microfarad-de/fridge-controller/doc/fridge-controller-schematic.pdf

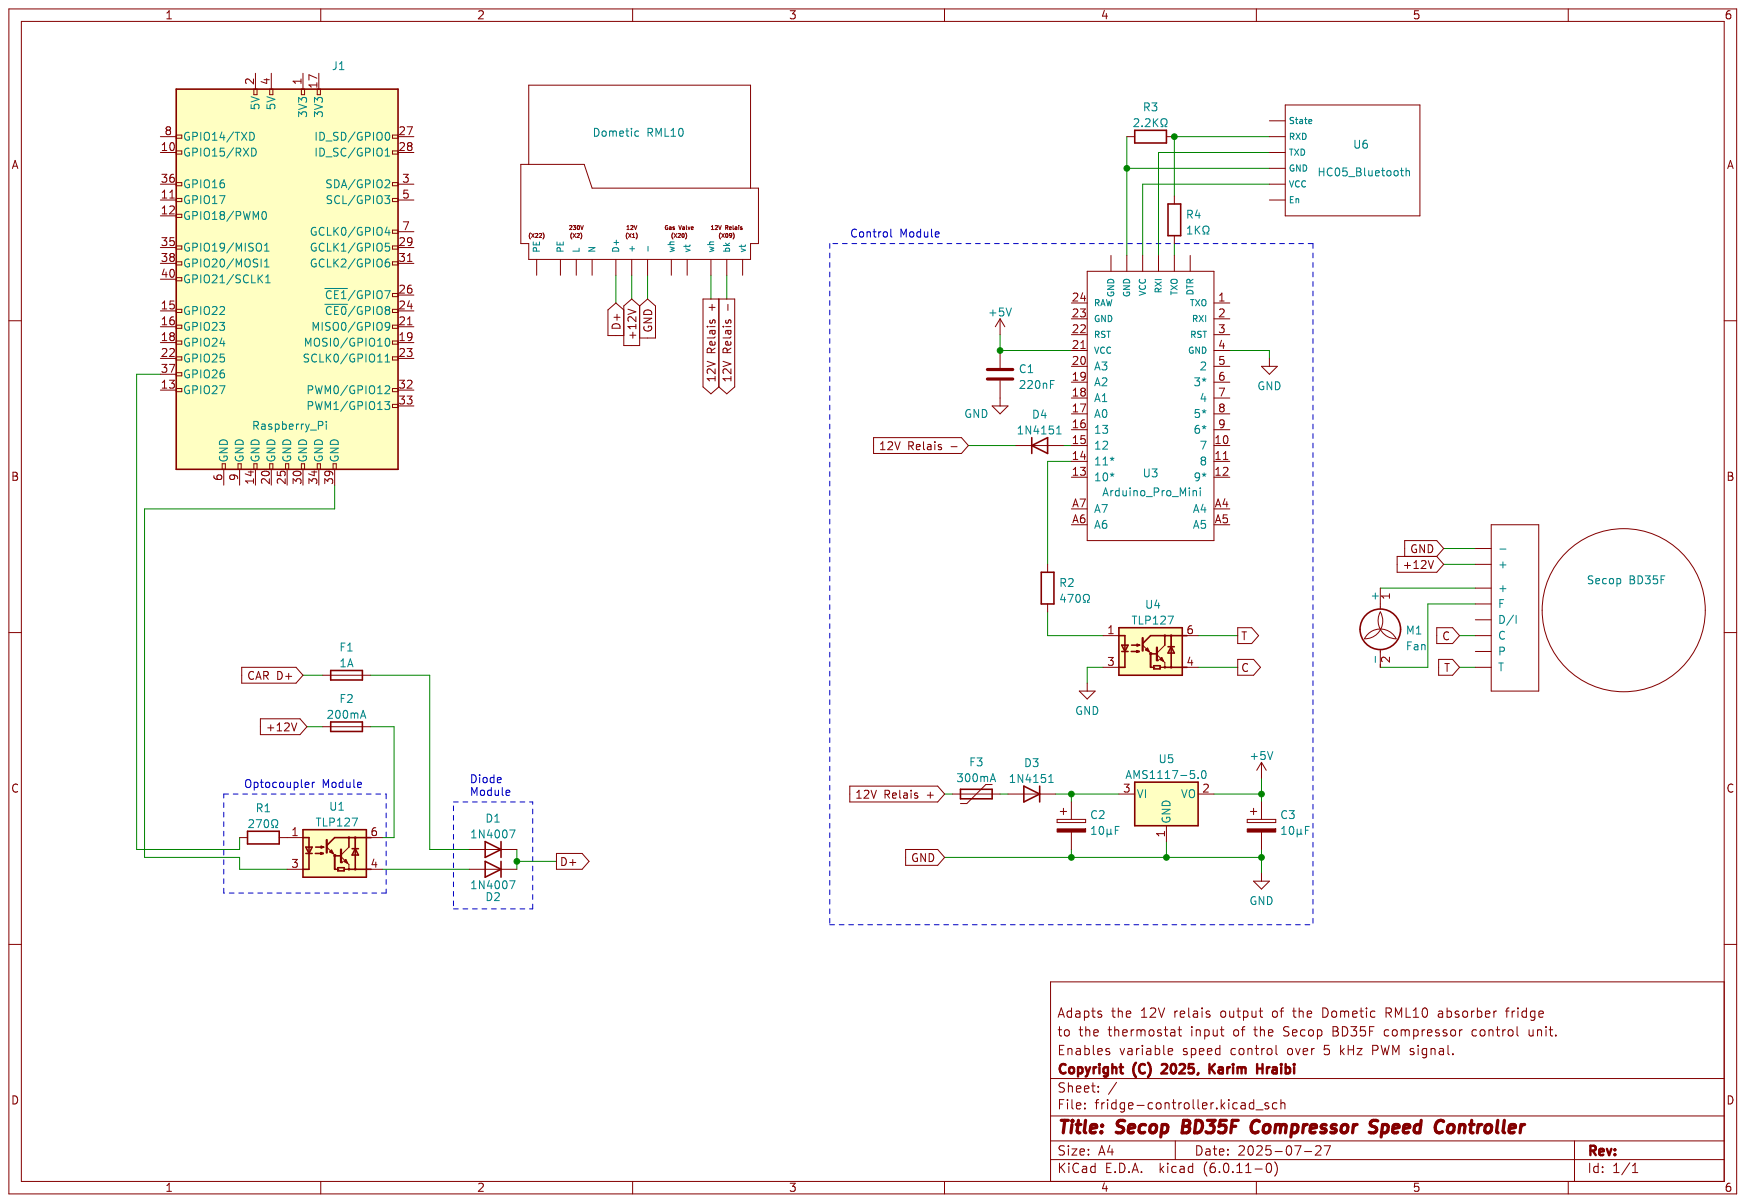
[picture p6: page 1]
