microfarad-de/fridge-controller/(commit log)

2025-02-09 Updated README and fixed typos
    [fridge-controller.ino]
2025-02-09 Added schematic
2025-02-10 Updated schematic
2025-02-13 Option to disable trace, README, comments
2025-02-13 Enable power save
2025-02-14 Set default PWM values
2025-03-02 Reworked speed control algorithm
    [fridge-controller.ino]
2025-03-02 Reset speed adjust divider
    [fridge-controller.ino]
2025-03-03 Revert speed adjust algorithm to version 1
    [fridge-controller.ino]
2025-03-18 Disable ADC
2025-05-17 Fixed fixed duty cycle meas buffer overflow
    [fridge-controller.ino]
2025-06-11 Separate speed adjust timers, increase parameter ranges, change timer unit to minutes.
2025-06-26 Fixed race condition within speed manager
    [fridge-controller.ino]
2025-06-28 Fast speed rampup after defrost, moved speed lock functionality into speed manager, trace duty cycle
2025-06-28 Disable automatic duty cycle measurement reset
    [fridge-controller.ino]
2025-06-29 Added trace message to MAX_SPEED state
2025-07-02 Bugfix: do not disable defrost during remote operation
    [fridge-controller.ino]
2025-07-02 Defrost: move runtime timer reset to the end of the defrost cycle
    [fridge-controller.ino]
2025-07-02 Reset remote pwm value on speed lock, refactor global variables
    [fridge-controller.ino]
2025-07-03 Set runtime timer to half time on interrupted defrost
2025-07-04 Introduced trace levels
2025-07-12 defrostManager(): Reset compressor runtime when entering defrost prepare state.
    [fridge-controller.ino]
2025-07-27 README: documented remote control via Raspberry Pi
2026-04-27 Dynamic defrost start runtime calculation for interrupted defrost cycles Defrost start runtime in tenths of an hour
2026-05-17 Bugfix: Speed adjustment disabled due to user adjustable duty cycle measurement window Display compressor on/off state duration Improved defrost start runtime display in h/m
    [fridge-controller.ino]
2026-05-29 Bugfix: reset defrost statue if off for defrost duration
    [fridge-controller.ino]
2026-06-14 Reset defrost runtime if defrost has been disabled by user
    [fridge-controller.ino]
2026-06-19 Bugfix: prevent max speed after disabling defrost with 'c 20' Bugfix: defrost cancel logic overrides regular handling Apply clock multiplier to speed adjust and trace timers
    [fridge-controller.ino]
2026-06-20 Prevent division by 0 during defrostRtStep calculation
    [fridge-controller.ino]
2026-07-02 Bugfix: cancel remote deforst command if off for more than defrost duration
    [fridge-controller.ino]
2026-07-09 Bugfix: defrost timeout overrides active defrost state
    [fridge-controller.ino]
2026-07-10 Updated trace library
2026-07-19 Clear watchdog reset flag
    [fridge-controller.ino]
2026-07-19 Power reduction: set all unused gpio to input with pull-ups
2026-07-22 Bugfix: defrost timeout overrides active defrost state (take 2)
    [fridge-controller.ino]
2026-07-22 Revert speed lock on and off delays to 15 and 10 minutes
    [fridge-controller.ino]
2026-07-24 Cancel maxsSpeed and remote speed commands when entering off state. This prevents executing those commands upon speed lock deactivation event when they are no longer relevant. Increase speed lock off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
    [fridge-controller.ino]
